MalteSaup/Morse-Messenger/Dokumentation/MorseMessenger_Plakat.pdf

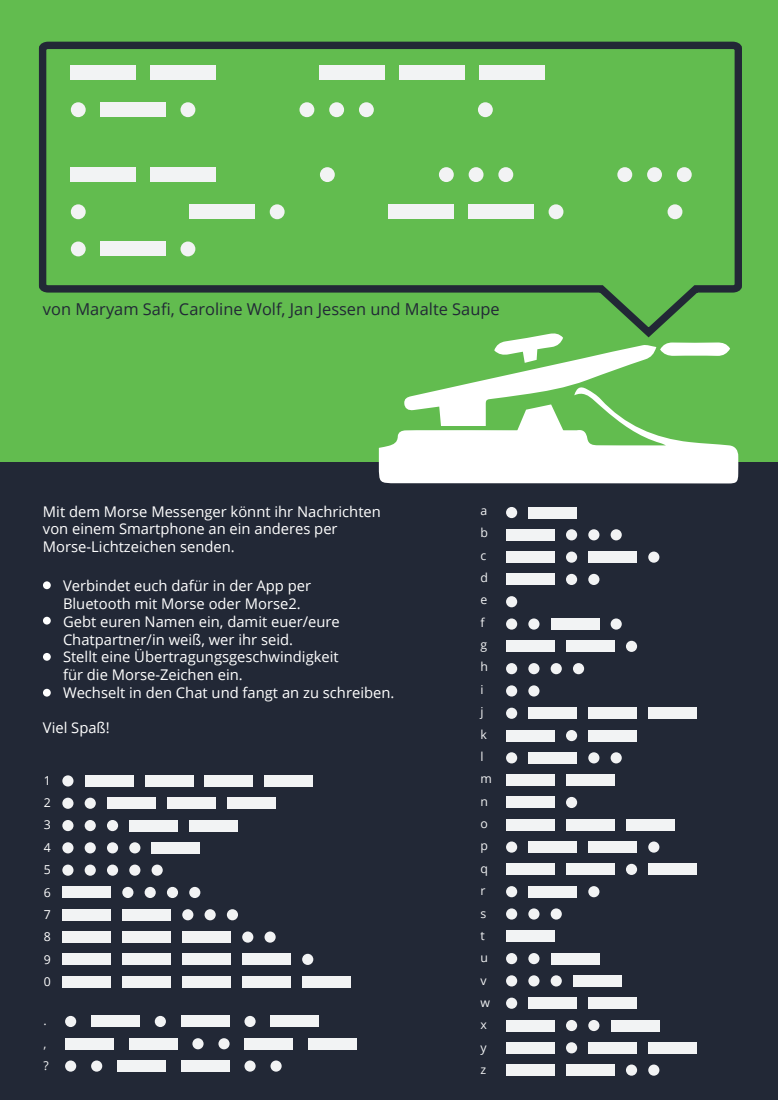
[picture p7: page 1]

von Maryam Safi, Caroline Wolf, Jan Jessen und Malte Saupe

Mit dem Morse Messenger könnt ihr Nachrichten
von einem Smartphone an ein anderes per
Morse-Lichtzeichen senden.

Verbindet euch dafür in der App per
Bluetooth mit Morse oder Morse2.
Gebt euren Namen ein, damit euer/eure
Chatpartner/in weiß, wer ihr seid.
Stellt eine Übertragungsgeschwindigkeit
für die Morse-Zeichen ein.
Wechselt in den Chat und fangt an zu schreiben.
Viel Spaß!
