MalteSaup/Morse-Messenger/(commit log)

2019-04-12 Layout LogIn
    [buttonshape.xml]
2019-04-12 DevicesAdapter for RecyclerView
2019-04-15 Tastatur öffnet sich nicht mehr beim öffnen der App, Button werden nicht mehr durch Tastatur verschoben, Bluetooth Switch mit Funktionen versehen
2019-04-16 Switch Correction
2019-04-17 OnClick Device
2019-05-08 Icon for BluetoothDevices, disconnect Button, Preparation for Receiving Data from Arduino, TODOs
    [buttonshape.xml]
2019-05-12 Ein paar Kommentare, Chat nur noch erreichbar wenn man mit dem Bluetooth Modul verbunden ist, Senden und Empfangen funktioniert
2019-05-15 Bugfix Disconnect-Button
2019-05-15 ChatActivity: Button + EditText alignment
2019-05-16 2 TODOS und Chat Button Bug versucht zu entfernen. Muss aber noch getestet werden
2019-05-21 Switch geht auf off wenn PERMISSION DENIED
2019-05-21 Reihenfolge Positions und Bildänderung verändert
2019-05-23 Connected Icon und Dopplung gefixt. Muss noch getestet werden. Zuwenig BT Geräte in der umgebung
2019-05-23 Feuert Log wenn BT Verbindung verloren. Zu langsam. >15 Sekunden zwischen abschalten BT Verbindung und Intent.
2019-05-26 No double devices in list
2019-06-08 Return aus ChatActivity wenn BT aus, kein automatischer Verbindungsabbruch mehr wenn zurück zur Main Activity, test mit Arduino von "\r" wenn in Arduino Code enthalten, ein paar Kommentare
2019-06-11 Create MM_unified_Photo_S.ino
    Test Arduino
2019-07-10 Bugfixes ACK/SEND filtering - deleted seekBar in MainActivity
2019-07-18 Arduino Code + Doku
